prusa3d/CW-CONTROLLER-PCB/README.md

# PRUSA CW controller board

KiCad PCB layout
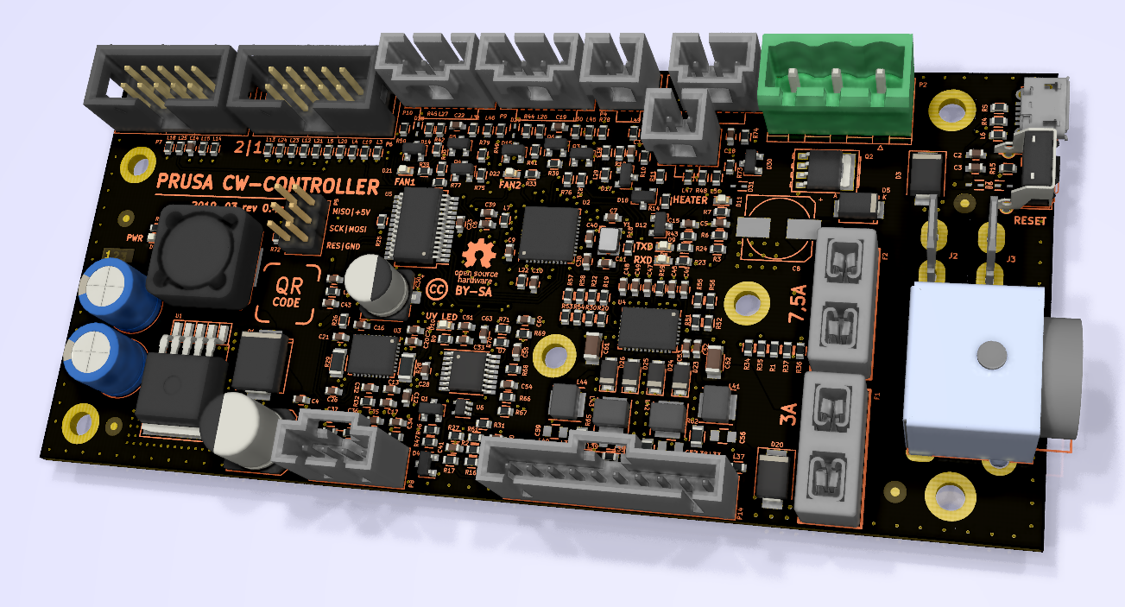
[picture p1: rev.04c/CW-controller-04c.png]
PCB


* [Interactive bom](http://htmlpreview.github.io/?https://github.com/prusa3d/CW-CONTROLLER-PCB/blob/master/rev.04c/ibom.html)
* [STEP 3D model](rev.04c/cw-controller-04c.step)
