prusa3d/CW-CONTROLLER-PCB/rev.04c/cw-controller-04c.pdf

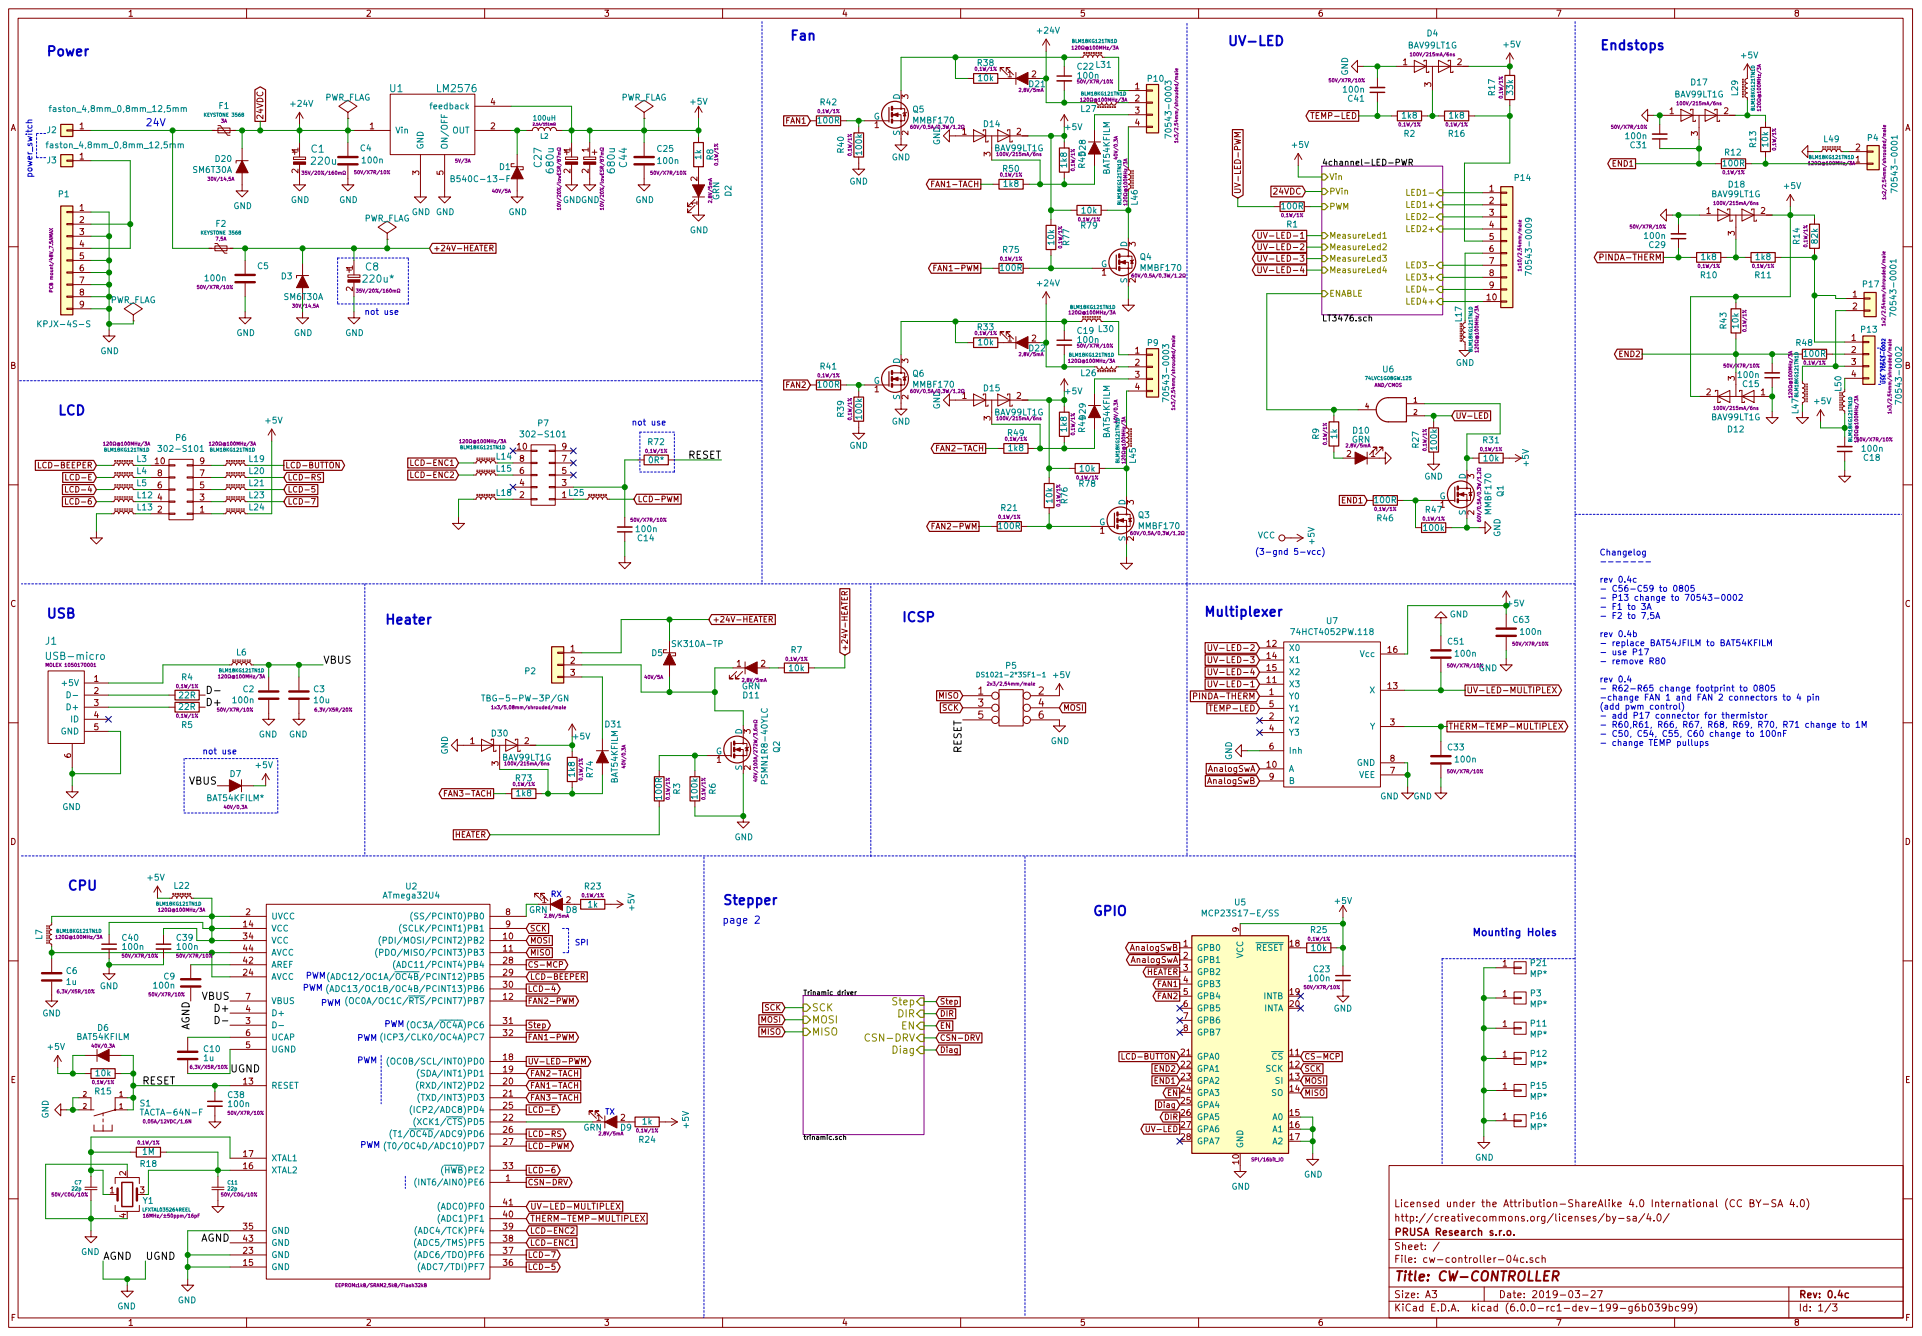
[picture p2: page 1]

3 D4 BAV99LT1G
50V/X7R/10% UV-LED-1 UV-LED-2 UV-LED-3 UV-LED-4

PINDA-THERM
TEMP-LED
THERM-TEMP-MULTIPLEX GND GND

- add P17 connector for thermistor
- R60,R61, R66, R67, R68, R69, R70, R71 change to 1M
- C50, C54, C55, C60 change to 100nF
- change TEMP pullups

CSN-DRV Diag SCK MOSI MISO

Licensed under the Attribution-ShareAlike 4.0 International (CC BY-SA 4.0) C11

File: cw-controller-04c.sch Sheet: / PRUSA Research s.r.o. http://creativecommons.org/licenses/by-sa/4.0/

Id: 1/3 Title: CW-CONTROLLER

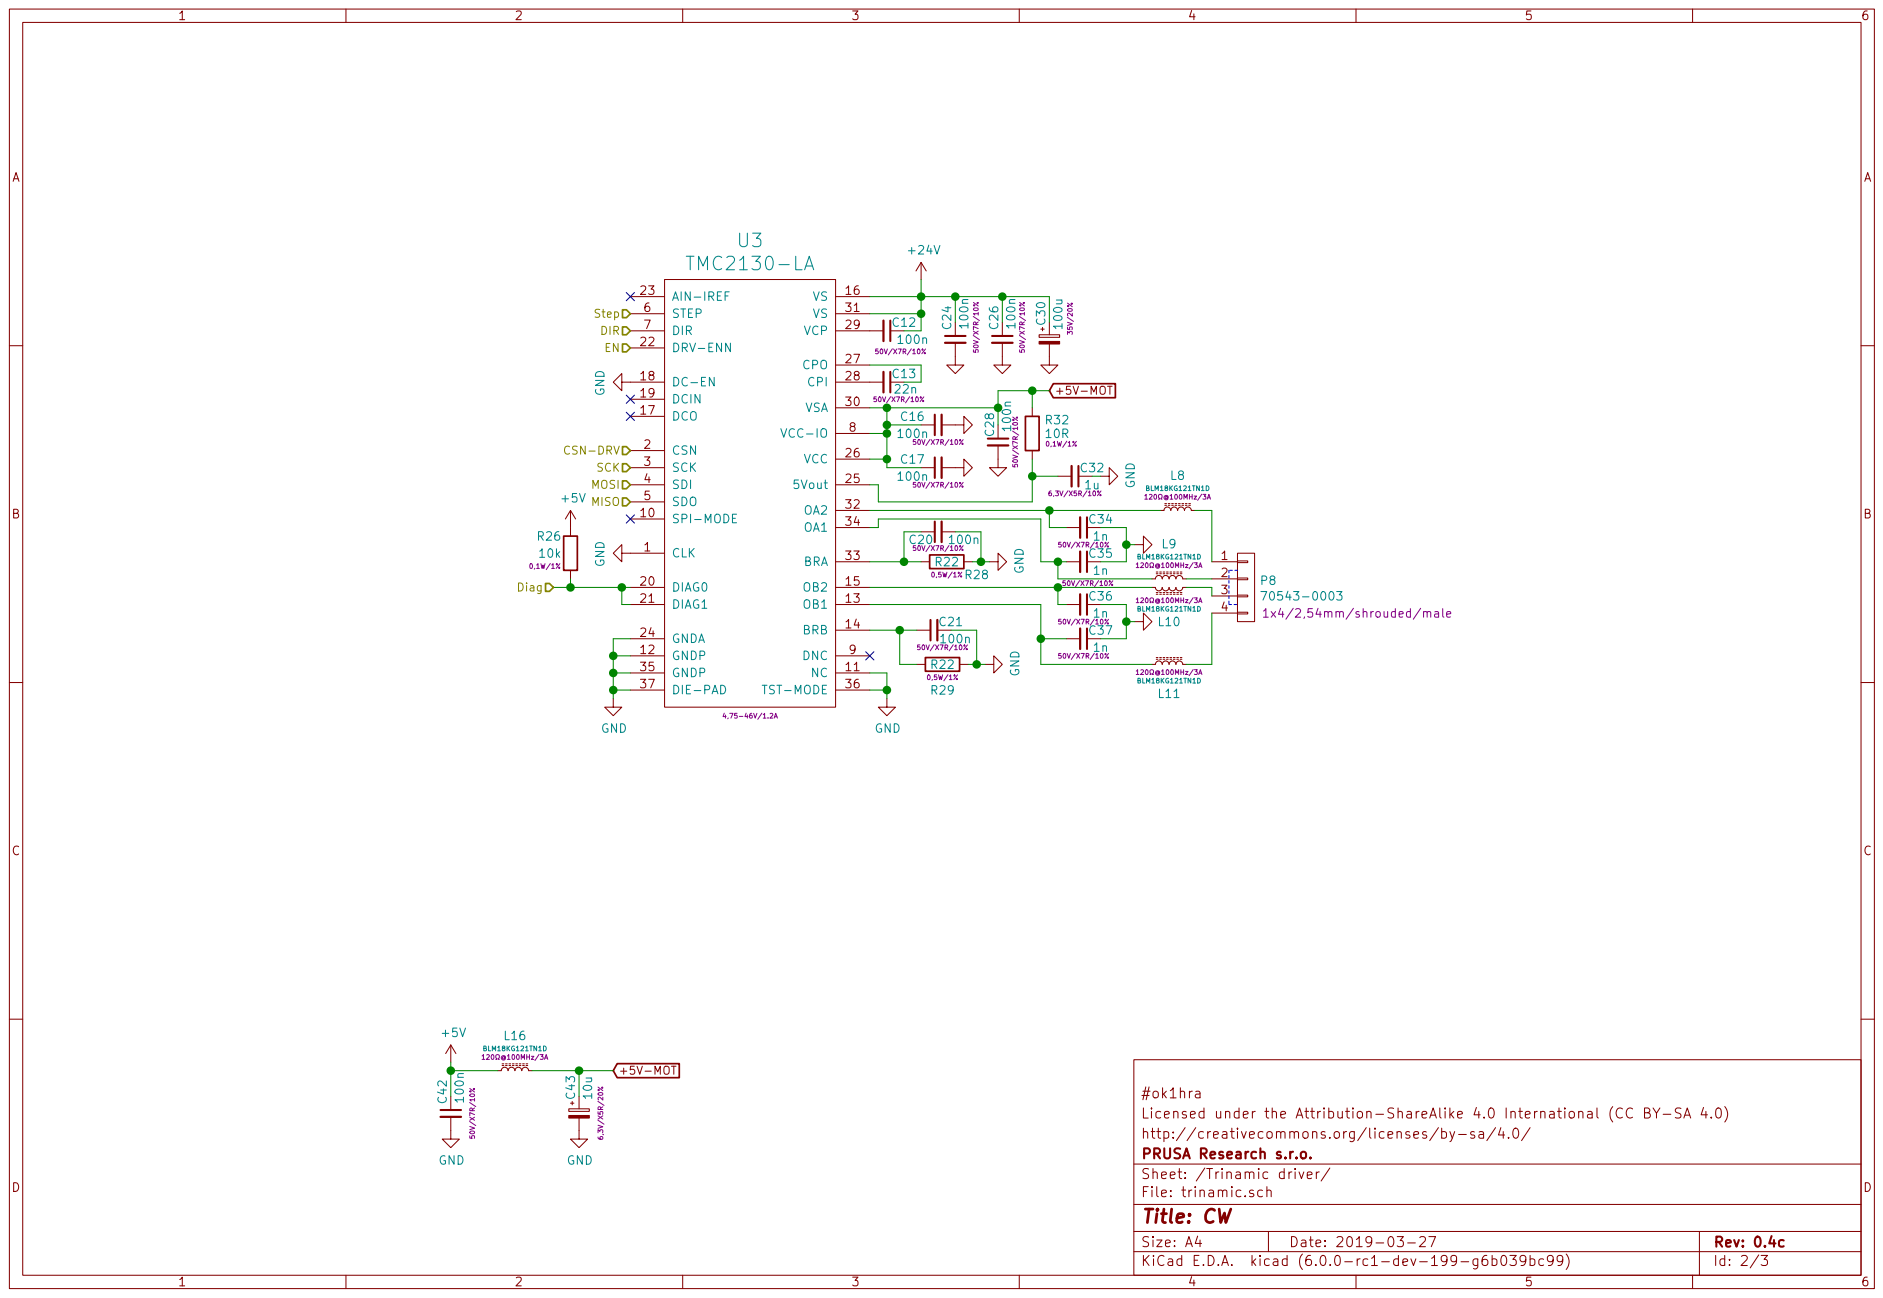
[picture p3: page 2]

File: trinamic.sch Sheet: /Trinamic driver/ PRUSA Research s.r.o. http://creativecommons.org/licenses/by-sa/4.0/

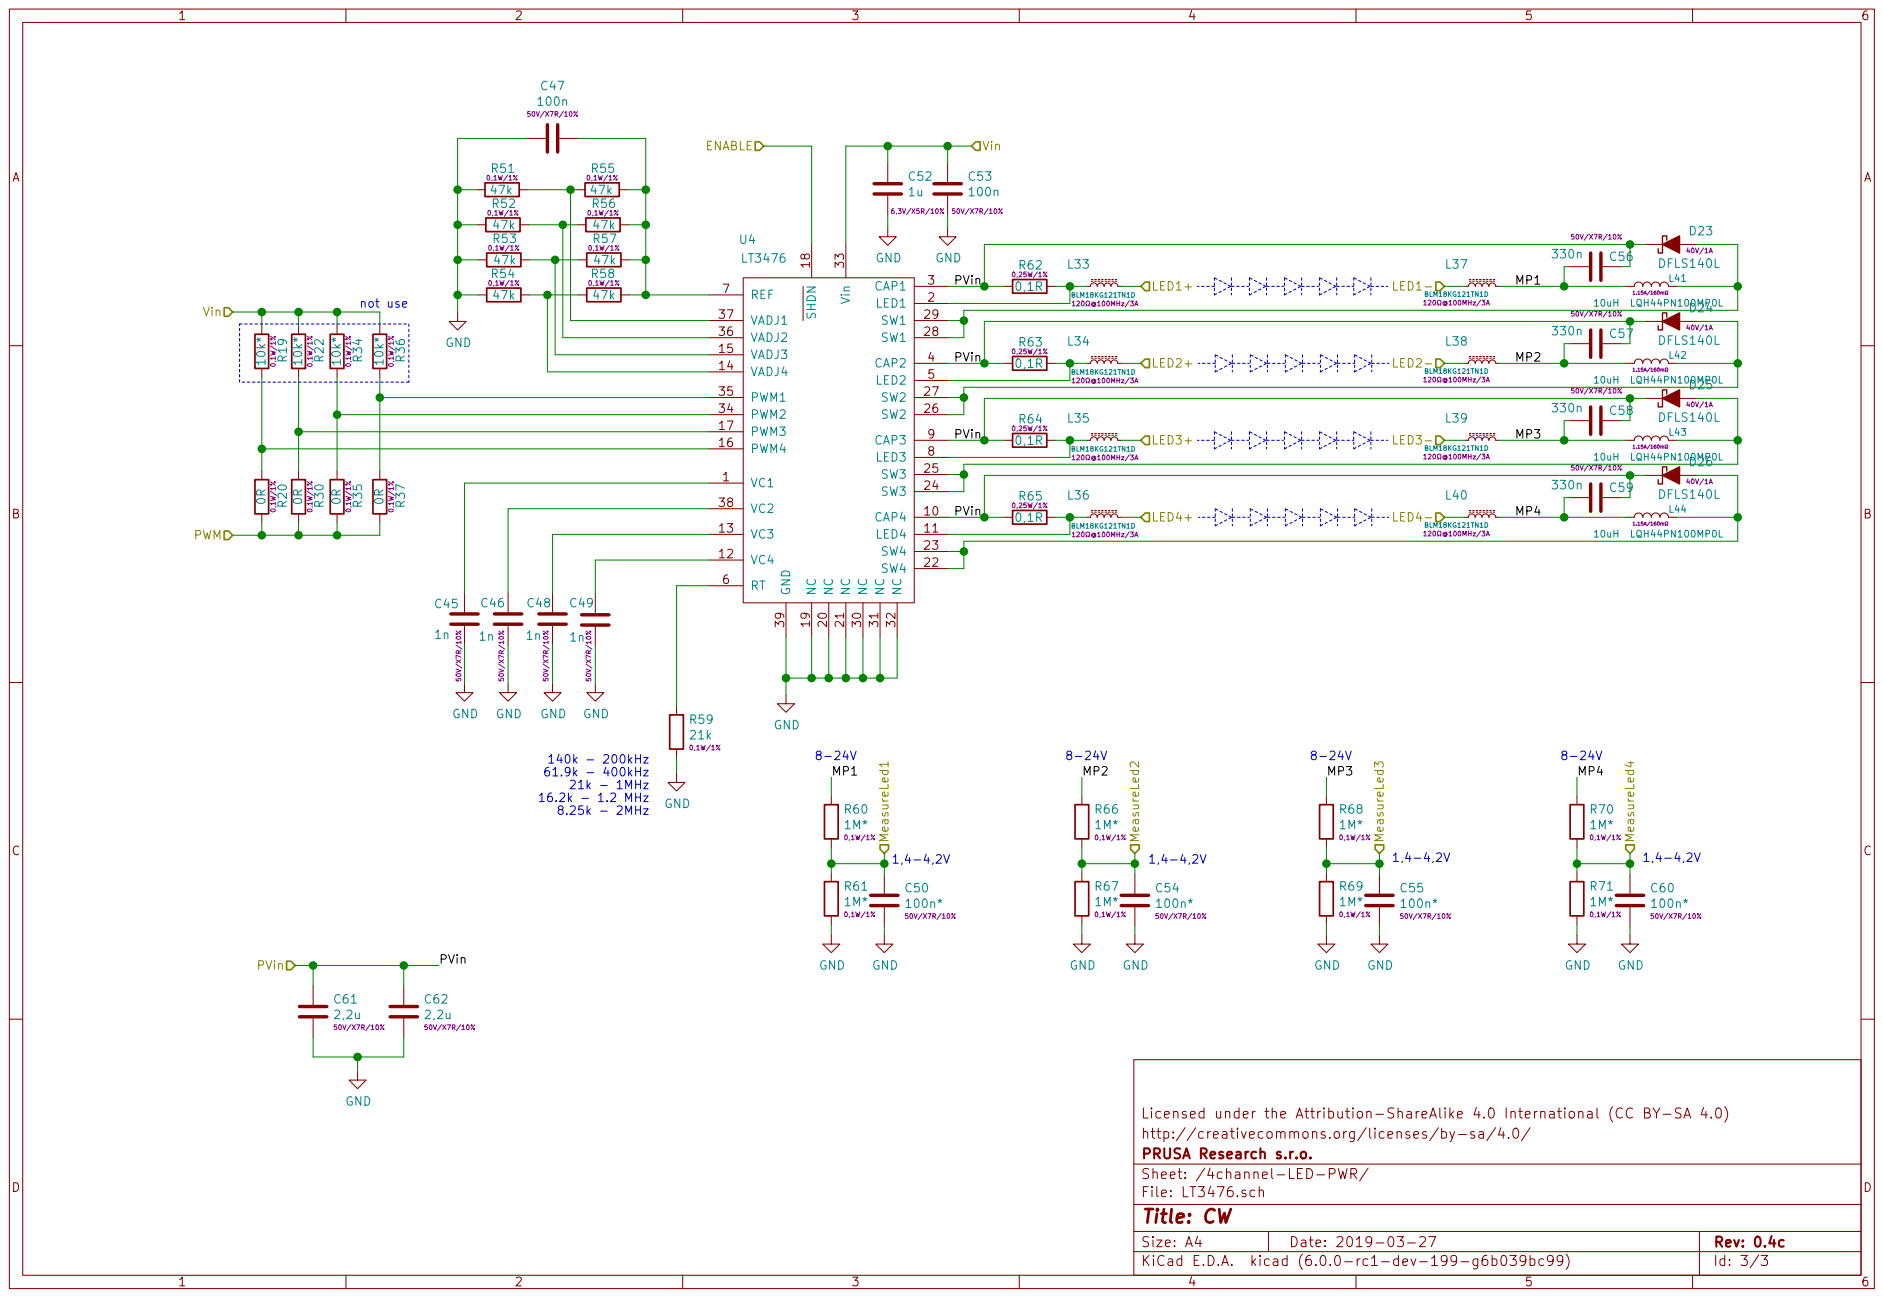
[picture p4: page 3]

Licensed under the Attribution-ShareAlike 4.0 International (CC BY-SA 4.0)
File: LT3476.sch Sheet: /4channel-LED-PWR/ PRUSA Research s.r.o. http://creativecommons.org/licenses/by-sa/4.0/
